dodther/Energomonitor/(threads)

Thread 1 (2019-03-21):

Вопросы по скетчу....

conrad66, 2019-03-21:
1. Переменные
byte TimeAdresseD = 9;
byte TimeAdresseN = 11;
ни где не используются, хотя вроде бы завлено кооретирование времени в блинке.
2. Где в скетче активная мощьность какой принцип расчета  реактивной мощьности ?
3. Скечь точно работоспособный ???
Чем больше вникаю, тем больше складывается впечатление что скетч сильно порезан.....

dodther, 2019-03-22:
1. Не используются так как я не дописал их использование. Это адреса в памяти где должны храниться значения перехода день и ночь на случай выключения питания.
2. Активную мощность выдаёт датчик в ваттах, Реактивная мощность считается в функции ReactivePower. Считается она умножением силы тока на напряжение, получаем полную мощность и из неё вычитаем активную. Но я не совсем уверен что так правильно.
3. Да, рабочий. Работает у меня на доме. Единственно забыл указать что загрузчик на нано надо сменить на оптибут, с родным не хватает места.

dodther, 2019-03-22:
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

1. Не используются так как я не дописал их использование. Это адреса в памяти где должны храниться значения перехода день и ночь на случай выключения питания.
2. Активную мощность выдаёт датчик в ваттах, Реактивная мощность считается в функции ReactivePower. Считается она умножением силы тока на напряжение, получаем полную мощность и из неё вычитаем активную. Но я не совсем уверен что так правильно.
3. Да, рабочий. Работает у меня на доме. Единственно забыл указать что загрузчик на нано надо сменить на оптибут, с родным не хватает места.

conrad66, 2019-03-22:
По поводу переменных понял, спасибо.
Есть еще несколько вопросов по скетчу, если позволите....
1. Что за порты в переменной ports[3][5], что значат те цифры в массивах?
2. vipe[3][4]; это три фазы по 4 получаемых значения с pzem ? я правильно понял ?
3. Что происходит при пропадании питания ?  и что даст хранение значений перехода день/ночь ?
4. Вы каждый раз в при переходе день - ночь выставляете флаг ResetWh = 1; тем самым обнуляя при переходе показание kWh в PZEN, я правильно понял ?
Можно как то обойти это если нет физической возможности  (транзисторы +оптопара ) обнулять показание  ?
p.s. уточните пожалуйста марку транзисторов которые Вы использовали, номинал второго резистора если оптопара, например, 817

conrad66, 2019-03-22:
5. Почему были выбраны 18 и 19 пины для сброса ? Они обязательно должны быть аналоговыми ?

conrad66, 2019-03-22:
Надо ли при первоночальном запуске скетча пины 18,19
выставлять в LOW ?
 digitalWrite(18, LOW);
 digitalWrite(19, LOW);
Или они по умочанию при включении arduino в LOW ?
При выставлении в HIGH, какой уровень на пинах 3.3в или 5в ?
Если использовать не ардуино, а например ESP8266, там вроде уровни 3.3в, такая схема будет работать ?

conrad66, 2019-03-22:
И еще вопрос ... а на обном MOSFET это нельзя было реализовать ?

dodther, 2019-03-23:
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

1. Это массив виртуальных пинов  в блинке. Так как опрос 3 датчиков идет в переборе массива, то и пины записал в массив и там-же при переборе отправляю данные в блинк.
2. Правильно.
3. При пропадании питания, естественно, всё выключается. В данный момент переход день\ночь берётся из блинка, если после восстановления питания интернета нет, то хранение этих значений позволит корректно делать переход день\ночь.
4. Верно. Сброс показаний возможен только нажатием кнопки. Других способов сброса нет. Можно в коде запоминать сколько уже насчтинано и пересчитывать. Но это надо переписывать код. Оптопара обычная 817 с дохлых БП. Транзисторы обычные полевики N и P. Из них собран инвертор сигнала. Дело в том что для обнуления показаний UART должен быть обесточен. Но если 5в подавать напрямик с ноги ардуины то впри подаче питания порт запитывается слишком поздно и не работает. А при инверторе 5В есть всегда и для их прерывания надо подать высокий уровень на инвертор.

>
>
>     1. Почему были выбраны 18 и 19 пины для сброса ? Они обязательно должны быть аналоговыми ?

Пины могут быть любыми. Ведь там только поднимаем и опускаем сигнал. Это может делать любая нога наны.

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

По умолчанию в низком. Естественно 5В, ведь это 5 вольтовая нана. Должна.

>
>
> И еще вопрос ... а на обном MOSFET это нельзя было реализовать ?

Это инвертор, нужно 2 транзистора. У мена были NDC7001, я их использовал. Но ничего не мешает использовать 2 отдельных транзистора.

conrad66, 2019-03-23:
спасибо, понял.
Какое сопротивление перед оптопарой ?

dodther, 2019-03-23:
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

Не помню. Вроде 4кОм. Можешь воспользоваться калькулятором для светодиодов.

conrad66, 2019-03-24:
В функции void firstRun(byte DD) есть такие строчки :
EEPROM.put(TarrifAdresseD , int(0));
EEPROM.put(TarrifAdresseN  , int(0));
И они не закомментированы.
А перменные TarrifAdresseD  и TarrifAdresseN   ни где не описаны.
Компиляция скетча с ошибкой.
На гитхабе точно рабочий скетч ? :)

conrad66, 2019-03-24:
И еще у меня вопросы.....
вот запустили ардуину или в первый раз или после пропадания питания..
Начал выполнятся
void setup()
Эти строчки понятно что делают :
DN = EEPROM.read(DNAdresse);
  firstRun(DN);
  kWhDayAllERROM = EEPROM.get(dAdresse, kWhDayAllERROM);
  kWhNightAllERROM = EEPROM.get(nAdresse,kWhNightAllERROM);
Вот по этим фунциям, есть вопросы.....
  kWhNightUpdate();
  kWhDayUpdate();

Допустим рассмотрм void kWhDayUpdate()
строчки вызывают сомнение :
  uint32_t kWhDay = (vipe[0][3] + vipe[1][3] + vipe[2][3]);
  kWhDayAll=kWhDayAllERROM+kWhDay;
Массив  vipe определен, но он ничем не  заполнен, не понятно какие там значения.
Он начинает заполнятся только при вызове функции readEnergy();, а ее еще не вызывали, она в void loop().

Что я не понимаю ????

dodther, 2019-03-27:
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

В смысле нигде не описаны? А что тогда в в 22 и 23 строках?

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

Там же есть комментарий для чего эту функцию пихнул в сетап. Костыль. Нули там.
Не стреляйте в пианиста, он играет как может.

conrad66, 2019-03-27:
В 22, 23 строчках :
byte TimeAdresseD = 9; // начала адресса куда буду писать время перехода на день
byte TimeAdresseN = 11; // начала адресса куда буду писать время перехода на ночь
а в коде :
EEPROM.put(TarrifAdresseD , int(0));
EEPROM.put(TarrifAdresseN , int(0));
и как раз
TarrifAdresseD  и TarrifAdresseN ни где не прописаны.

dodther, 2019-03-28:
"Шарик, ты балбес..." Исправил. :)

conrad66, 2019-03-28:
И последний для меня не ясный вопрос...
зачем в функциях NightToDay() и DayToNight() происходит обнуления массива vipe ?
Комментарий читал что "функция подсчёта находится ниже", но не понял логики.
Не могли бы вы "разжевать" этот вопрос ?
Почему функция подсчёта не поставить ниже ? и в каком это месте вообще ? :)

Closed 2019-04-02.
