dodther/Energomonitor/(commit log)

2019-01-06 Добавил картинку настроек
2019-01-06 Залил схему инвертора
    Схема инвертора для питания Serial порта PZEM-004T. Позволяет отключать пор подачей высоко уровня на пин Ардуины.
2019-01-07 Добавил схему подключения
2019-01-09 Добавил раздел "Что хочу сделать".
2019-01-11 Update energy_0.3.ino
    Добавил возможность работы при отвале интернета. В старой версии пытался соединиться с серверами Blynk и при этом выполнение кода приостанавливалось. Из-за этого не происходил переход тарифа. Теперь запросы на подключение к серверу идут с частотой 1мин, а подсчёт энергии идёт параллельно.
2019-01-11 Update energy_0.3.ino
    Убрал таймер. Он использовался только для вызова функции проверки связи. Сэкономил 600байт. Функцию вызываю через millis().
